keab/os3m-hardware/README.md

# os3m-hardware
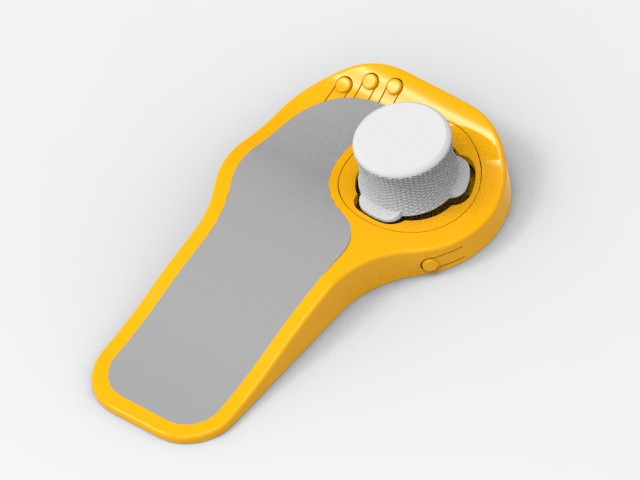
[picture p1: mech_overview.jpg]


This repo adds another mechanical design for OS3M, see the Ergo_mech folder

It also adds some modified PCB files which work directly for a JLCPCB PBA order
