keab/os3m-hardware/PCB/README.md

# OS3M Mouse PCB
The gerber zip is unmodified from the original spoter368 repo, kept here for convenience

OS3M_Mouse-top-pos_JLCPCB.csv is a placement file which matches the positions and orientations of JLCPCB

JLCPCB_BOM_DNTT.csv is a BOM which uses the DNTT version of U3, since they have that in stock at JLCPCB
