keab/os3m-hardware/Ergo_mech/SolidEdge/README.md

# Design files

I work in Solid Edge Community edition.

Some notes:

The HEIA files are copied from the fork https://github.com/Overlord6644/os3m-hardware

Raw_base.par is the base plate for screwing the PCB and attaching the knob. Useful if you want to make your own mechanical design.
