keab/os3m-hardware/Ergo_mech/bottom_lid.png

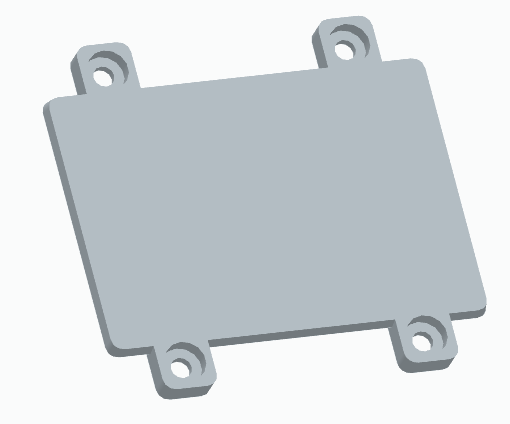
Ergo_mech/bottom_lid.png
