keab/os3m-hardware/Ergo_mech/hiddenparts.png

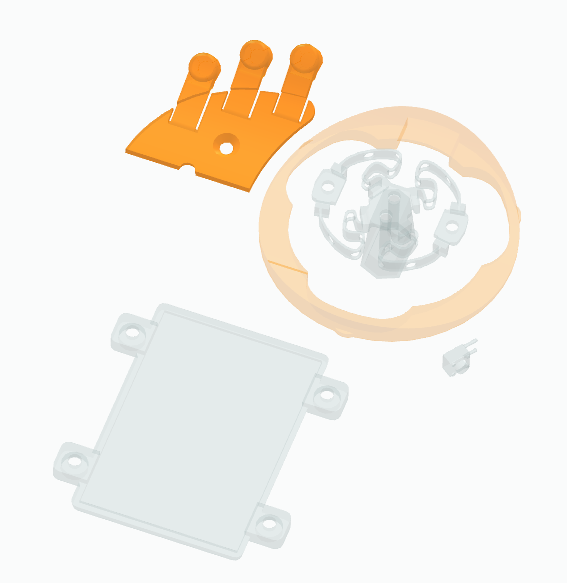
Ergo_mech/hiddenparts.png
