keab/os3m-hardware/Ergo_mech/Exports/cap.stl

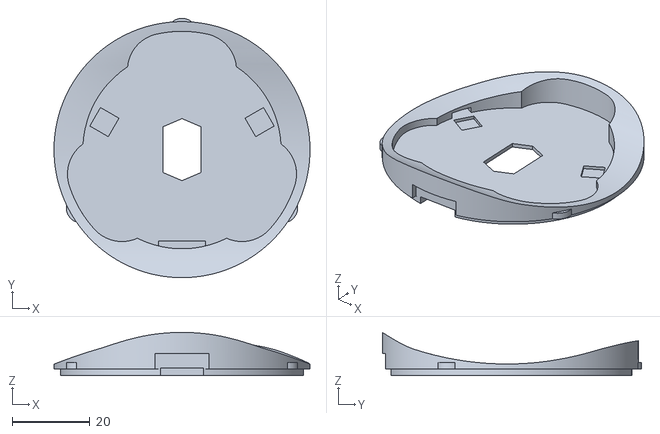
[picture p14: CAD file, 2024-12-04]
Ergo_mech/Exports/cap.stl
66.0 x 66.8 x 11.1
