keab/os3m-hardware/Ergo_mech/Exports/wireholder.stl

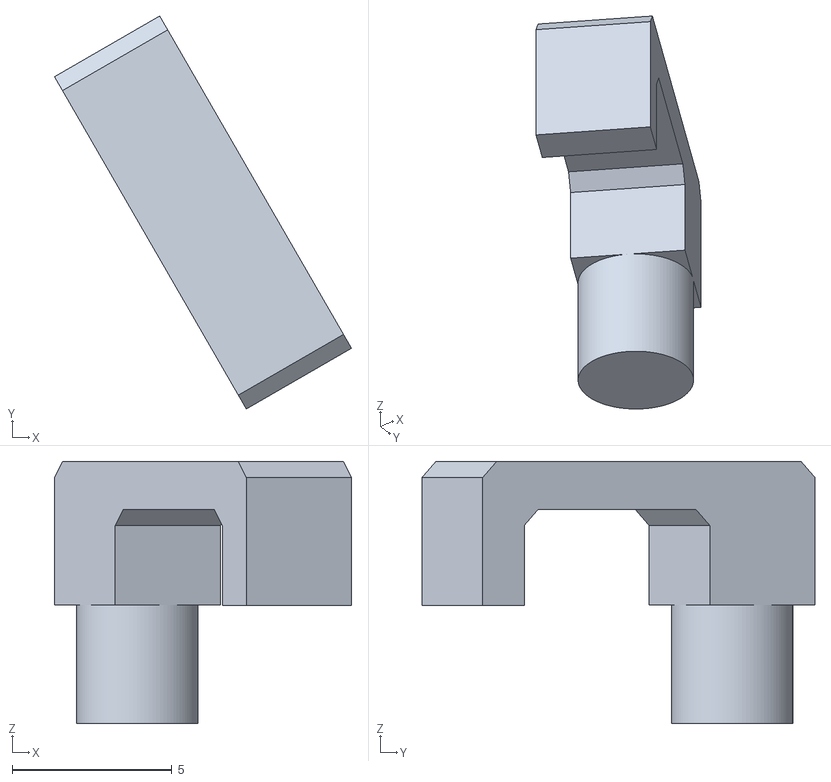
[picture p15: CAD file, 2024-12-04]
Ergo_mech/Exports/wireholder.stl
9.29 x 12.3 x 8.20
