keab/os3m-hardware/Ergo_mech/Exports/lpurdy_Flexure_Mini_Renforced_plus04.stl

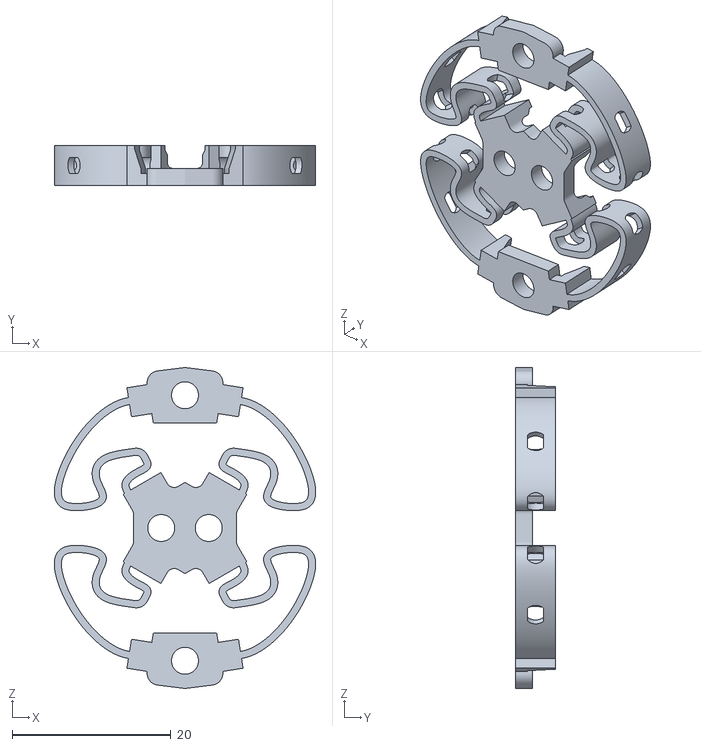
[picture p16: CAD file, 2024-12-04]
Ergo_mech/Exports/lpurdy_Flexure_Mini_Renforced_plus04.stl
33.0 x 5.00 x 40.5
