keab/os3m-hardware/Ergo_mech/Exports/Stem.stl

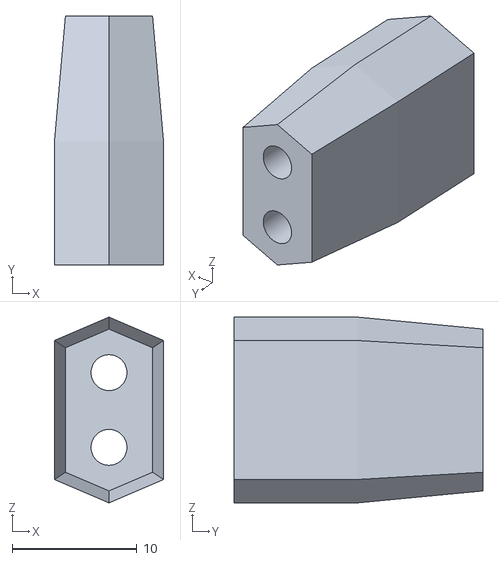
[picture p17: CAD file, 2024-11-10]
Ergo_mech/Exports/Stem.stl
8.76 x 20.0 x 14.9
