keab/os3m-hardware/Ergo_mech/Exports/3buttons.stl

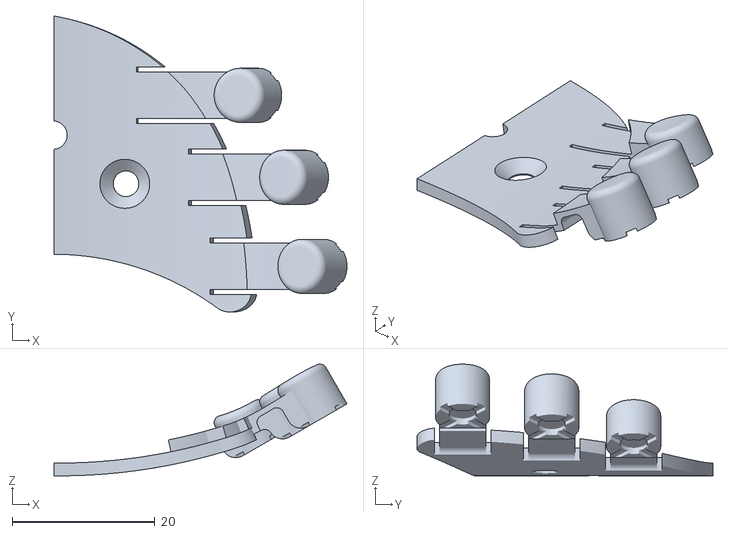
[picture p18: CAD file, 2024-11-03]
Ergo_mech/Exports/3buttons.stl
41.1 x 41.5 x 15.7
