keab/os3m-hardware/Ergo_mech/Exports/1button.stl

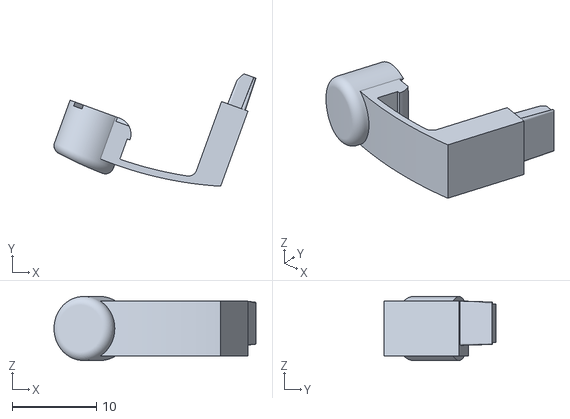
[picture p19: CAD file, 2024-11-02]
Ergo_mech/Exports/1button.stl
24.0 x 13.4 x 7.60
