keab/os3m-hardware/Ergo_mech/Exports/bottom_lid.stl

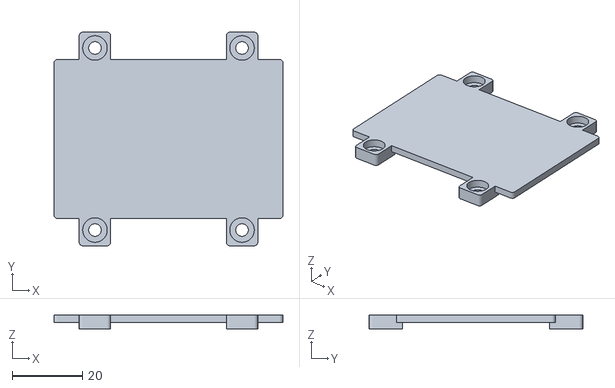
[picture p20: CAD file, 2024-11-02]
Ergo_mech/Exports/bottom_lid.stl
65.4 x 61.0 x 4.00
