keab/os3m-hardware/Ergo_mech/Exports/Foam - stencil.stl

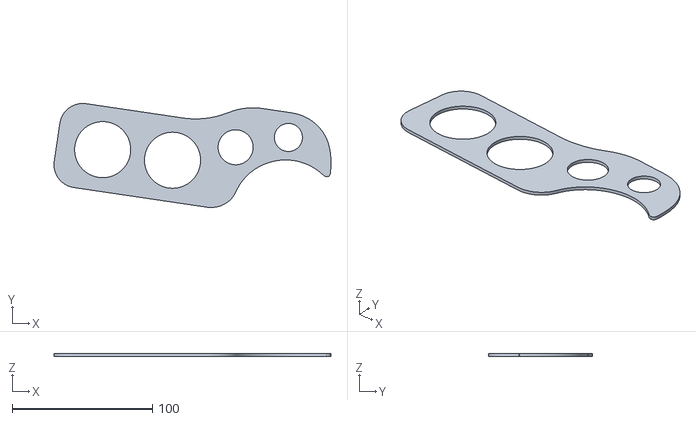
[picture p21: CAD file, 2024-10-22]
Ergo_mech/Exports/Foam - stencil.stl
197.7 x 74.3 x 2.00
