keab/os3m-hardware/Ergo_mech/Exports/Flexure_Mini_Renforced.3mf

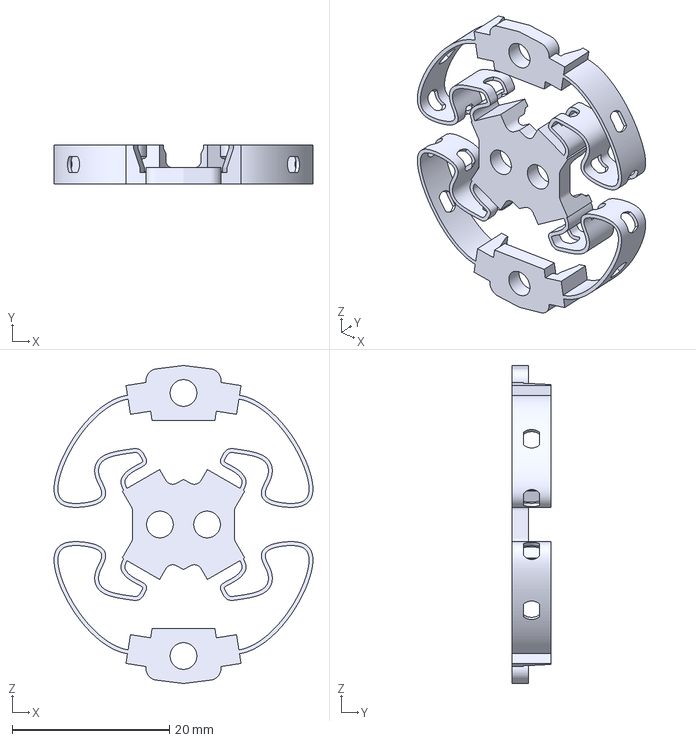
[picture p22: CAD file, 2024-10-22]
Ergo_mech/Exports/Flexure_Mini_Renforced.3mf
33.0 x 5.00 x 40.5 mm
