keab/os3m-hardware/Ergo_mech/Exports/cap_mini.stl

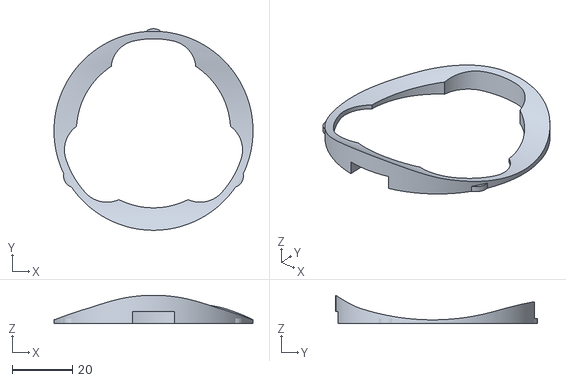
[picture p23: CAD file, 2024-10-22]
Ergo_mech/Exports/cap_mini.stl
66.0 x 66.8 x 9.43
