keab/os3m-hardware/PCB/Schematics.pdf

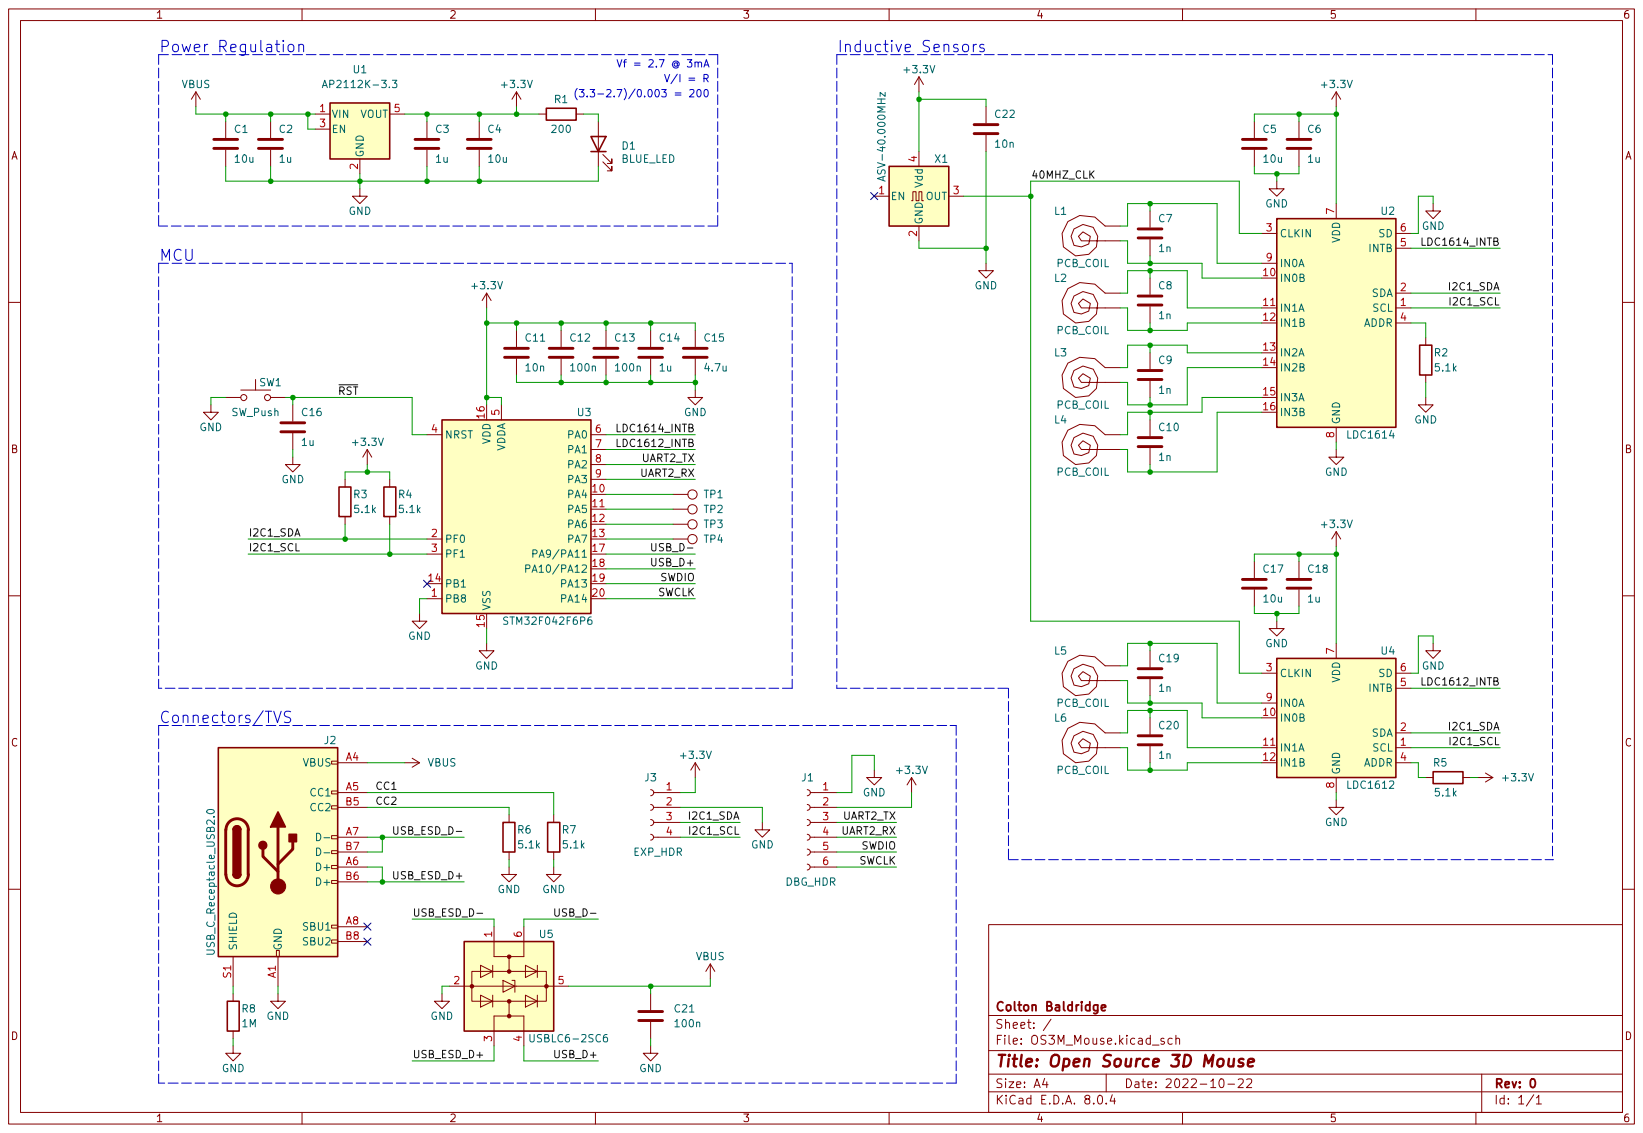
[picture p24: page 1]
