keab/os3m-hardware/Ergo_mech/custom_target_mod.pdf

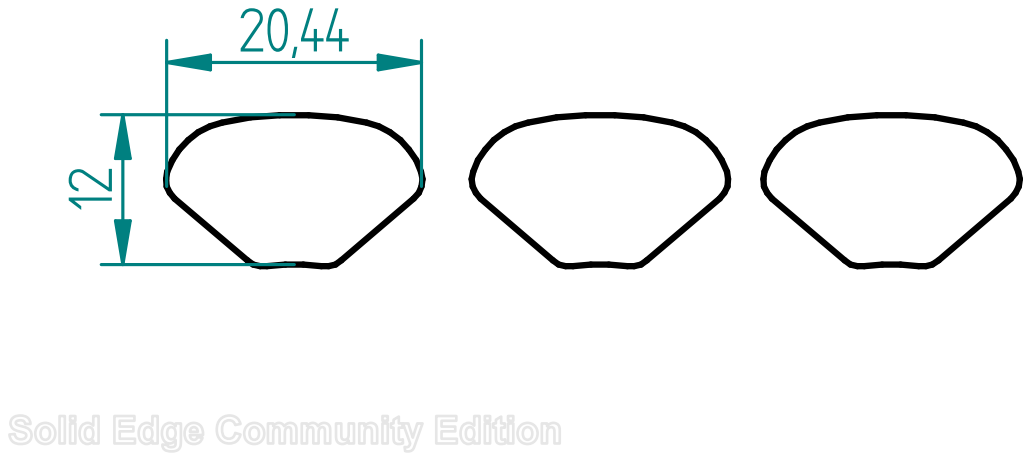
[picture p25: page 1]
