keab/os3m-hardware/Ergo_mech/custom_target.pdf

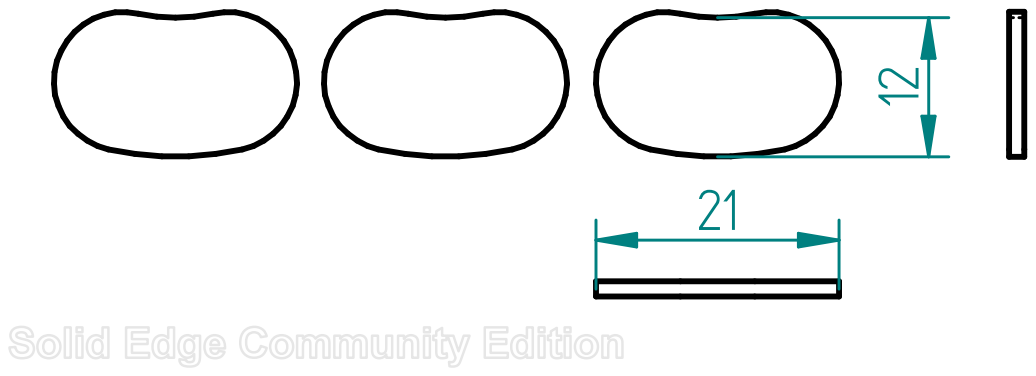
[picture p26: page 1]
