keab/os3m-hardware/(commit log)

2024-10-22 Removed all files not useful for this fork
    [Assembly.SLDASM, Base.3MF, Base.SLDPRT, Base.STEP, FlexureMini.3MF, FlexureMini.SLDPRT, FlexureMini.STEP, HandRest.3MF]
2024-10-22 BOM with the DNTT version of the sensor, and a position file matching JLCPCBs database
    [JLCPCB_BOM_DNTT.csv, OS3M_Mouse-top-pos_JLCPCB.csv]
2024-10-22 First commit of the mechanical design. Bottom lid and Cap may still need some adjustments Also including lpurdy's reinforced flexure
    [3buttons.stl, Flexure_Mini_Renforced.3mf, Foam - stencil.stl, bottom_lid.stl, cap.stl, os3m_assy.cfg]
2024-10-22 Improved readme files and added a couple of pictures
2024-10-29 Moved thumb switch 10mm forward Made thumb button a separate part (may need slight adjustment still for a suitable press fit) Corrected bottom lid (there was a 0.5 mm error)
    [1button.stl, bottom_lid.stl, os3m_assy.cfg]
2024-11-02 Added a PDF print of the v2.0 schematics
2024-11-02 Corrected a model error
    [bottom_lid.stl]
2024-11-02 Added another reinforced flexure.
    [FlexureMini_02_thicker.stl]
2024-11-02 Decreased "counterbore" for stem screws, since it was too deep to allow 10 mm screws. Added tapering to the 1button part. Improved the readme
    [1button.stl, os3m_assy.cfg]
2024-11-03 Increased flexibility of third button
    [3buttons.stl]
2024-11-10 Add PBA as Step file, first generated by KiCad and then opened in SE and exported as single part
2024-11-10 Old cap renamed
    [cap_mini.stl]
2024-11-10 Made the cap completely cover the PCB Modified Stem to better fit with the cap Added PBA to the assembly Added hole(s)in the base to access the RX/TX pins Not sure what was changed in the lid...
    [Stem.stl, cap.stl, os3m_assy.cfg]
2024-11-11 Cap: Modified switch cut-out Target: Cut-off corners Improved readme file
    [os3m_assy.cfg]
2024-11-12 Exported update of the cap. Should have been included in the Nov 11 commit
    [cap.stl]
2024-11-14 Modified the boot-switch holes in base and updated Readme
    [os3m_assy.cfg]
2024-11-15 Moved and removed some files
    [FlexureMini_02_thicker.stl, Flexure_Mini_Renforced.3mf, Stem.3MF]
2024-12-04 Added wireholders; Added stiffer flexure; Small cap change. Compatible with parts in previous commits.
    [cap.stl, lpurdy_Flexure_Mini_Renforced_plus04.stl, os3m_assy.cfg, wireholder.stl]
